bikerglen/rp2040-midi-player/case/dac-version/standoff M2 x 5 x 7.8 mm.3mf

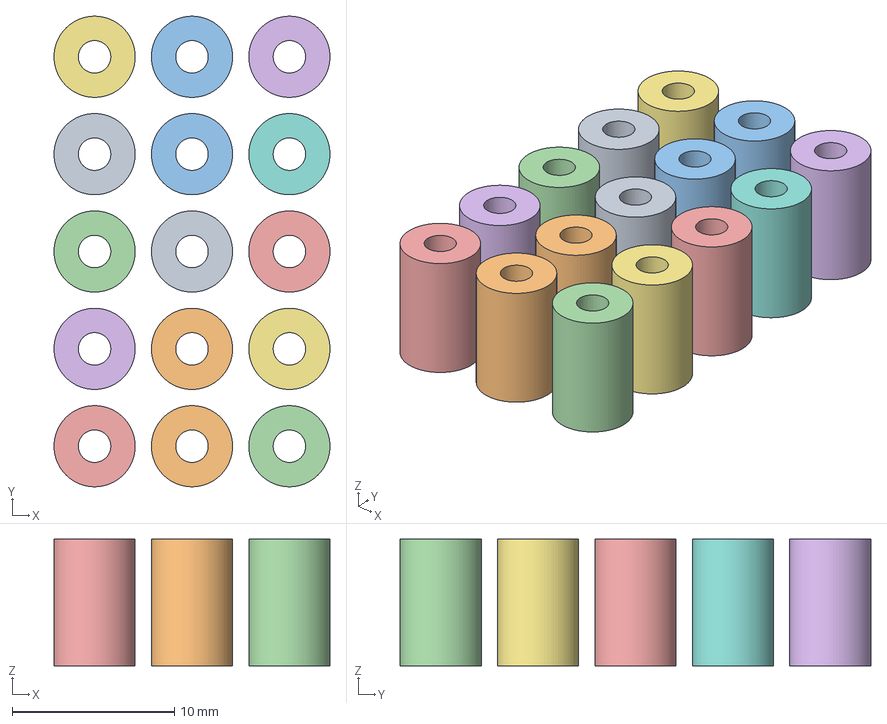
[picture p1: CAD file, 2026-02-13]
case/dac-version/standoff M2 x 5 x 7.8 mm.3mf
17.0 x 29.0 x 7.80 mm
