bikerglen/rp2040-midi-player/case/led-light-guide/lightguides 2.2mm.3mf

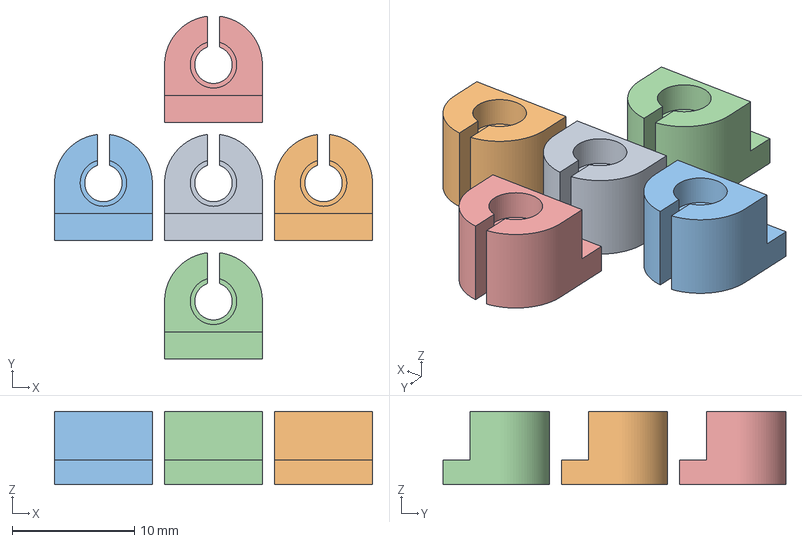
[picture p2: CAD file, 2026-02-07]
case/led-light-guide/lightguides 2.2mm.3mf
26.0 x 28.0 x 6.00 mm
