bikerglen/rp2040-midi-player/case/midi-fighter-stand/Midi Fighter Stand.3mf

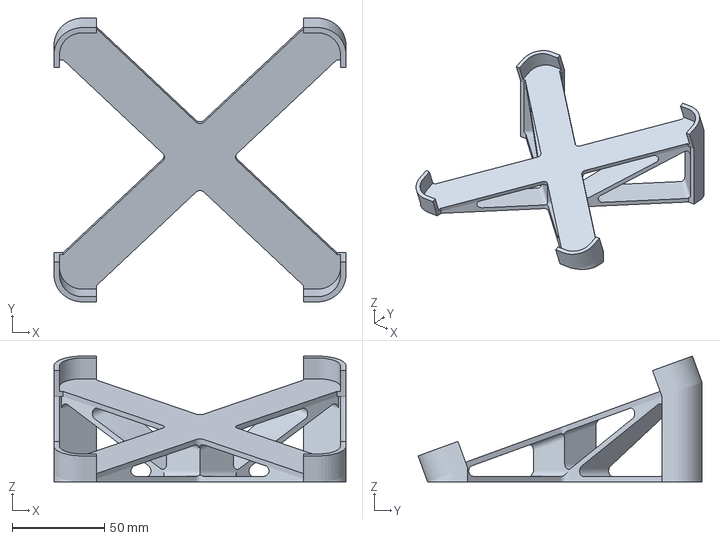
[picture p3: CAD file, 2026-02-12]
case/midi-fighter-stand/Midi Fighter Stand.3mf
158.0 x 153.6 x 68.1 mm
