bikerglen/rp2040-midi-player/case/noise-box-2000/noise-box-2000-led.3mf

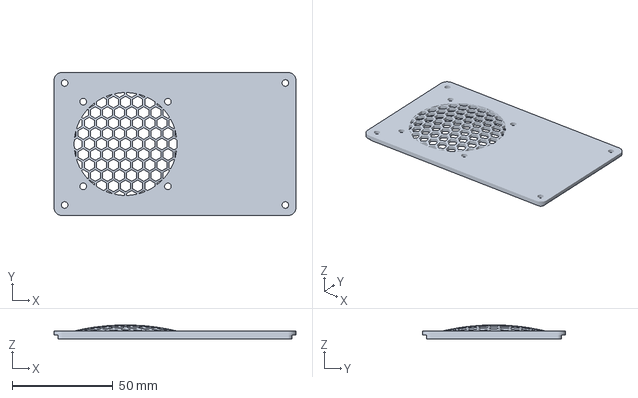
[picture p4: CAD file, 2026-02-18]
case/noise-box-2000/noise-box-2000-led.3mf
120.0 x 71.0 x 6.97 mm
