bikerglen/rp2040-midi-player/case/spkr-version/midi player speaker body, gray basic.3mf

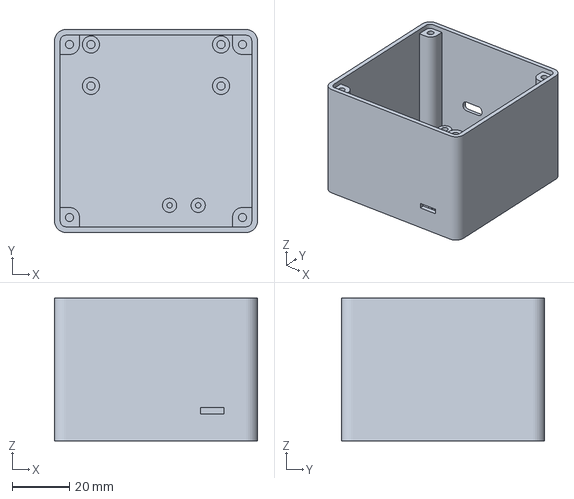
[picture p5: CAD file, 2026-02-07]
case/spkr-version/midi player speaker body, gray basic.3mf
71.0 x 71.0 x 50.0 mm
