bikerglen/rp2040-midi-player/case/dac-version/midi player dac box matte gray pla.3mf

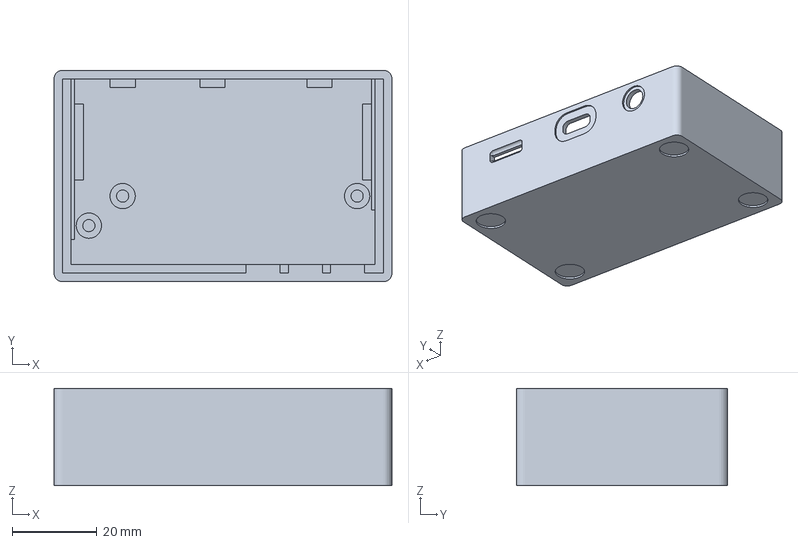
[picture p6: CAD file, 2026-02-13]
case/dac-version/midi player dac box matte gray pla.3mf
80.0 x 50.0 x 23.0 mm
