bikerglen/rp2040-midi-player/case/spkr-version/midi player speaker lid, yellow and red.3mf

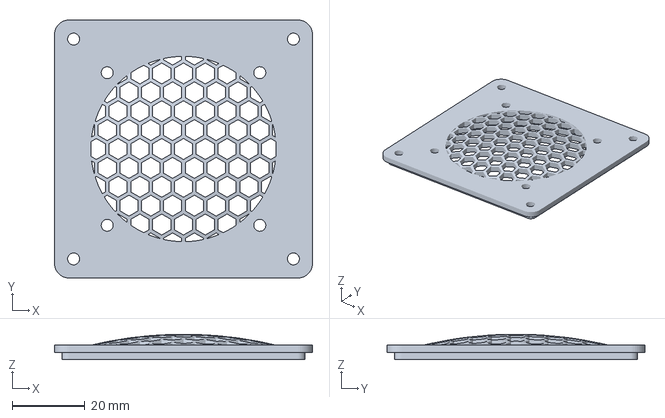
[picture p8: CAD file, 2026-02-07]
case/spkr-version/midi player speaker lid, yellow and red.3mf
71.0 x 71.0 x 6.97 mm
