bikerglen/rp2040-midi-player/case/dac-version/midi player dac lid matte gray pla.3mf

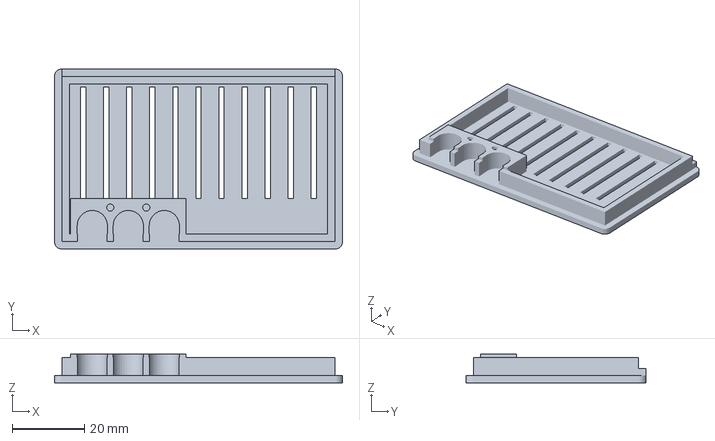
[picture p9: CAD file, 2026-02-07]
case/dac-version/midi player dac lid matte gray pla.3mf
80.0 x 50.0 x 8.00 mm
