bikerglen/rp2040-midi-player/case/spkr-version/led cover for base mount.3mf

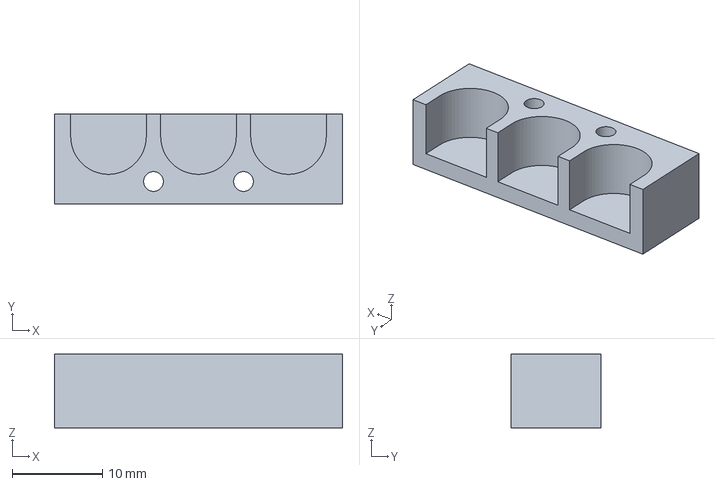
[picture p10: CAD file, 2026-02-07]
case/spkr-version/led cover for base mount.3mf
32.0 x 10.0 x 8.20 mm
