bikerglen/rp2040-midi-player/pcb/qwiic-led-board/leds-2.pdf

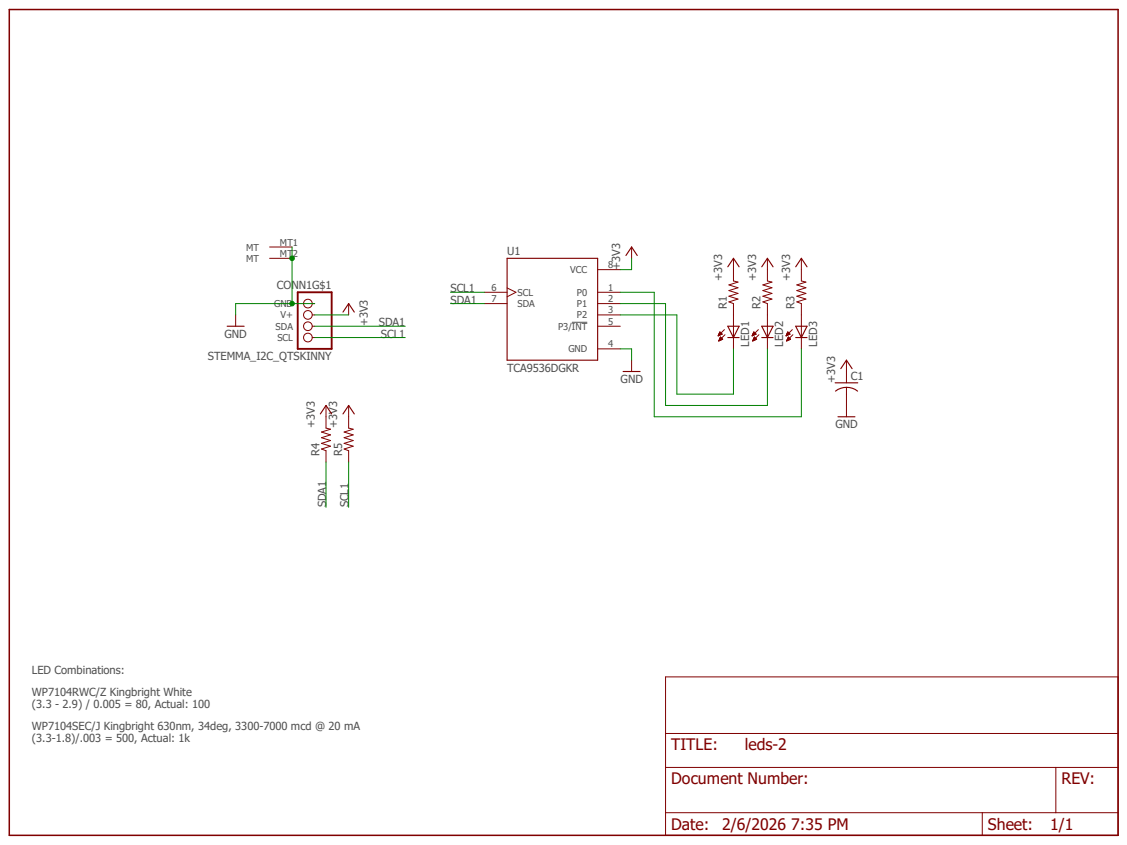
[picture p11: page 1]
TCA9536DGKR; STEMMA_I2C_QTSKINNY; GND; GND ⁺³V3 +³V3; LED¹; LED²; LED³; 4 P3/INT; SCL 6; SDA 7; VCC; GND V+ SDA SCL; CONN1G$1 MT; SDA1; SDA1 SDA¹; SCL1; SCL1 SCL1; TITLE:; leds-2

LED Combinations:
WP7104RWC/Z Kingbright White
(3.3 - 2.9) / 0.005 = 80, Actual: 100
WP7104SEC/J Kingbright 630nm, 34deg, 3300-7000 mcd @ 20 mA
(3.3-1.8)/.003 = 500, Actual: 1k

Document Number: | REV:

Date: 2/6/2026 7:35 PM | Sheet: 1/1
