bikerglen/rp2040-midi-player/pcb/dac-version/soundboard-qtpy-usd-dac-smaller-v02.pdf

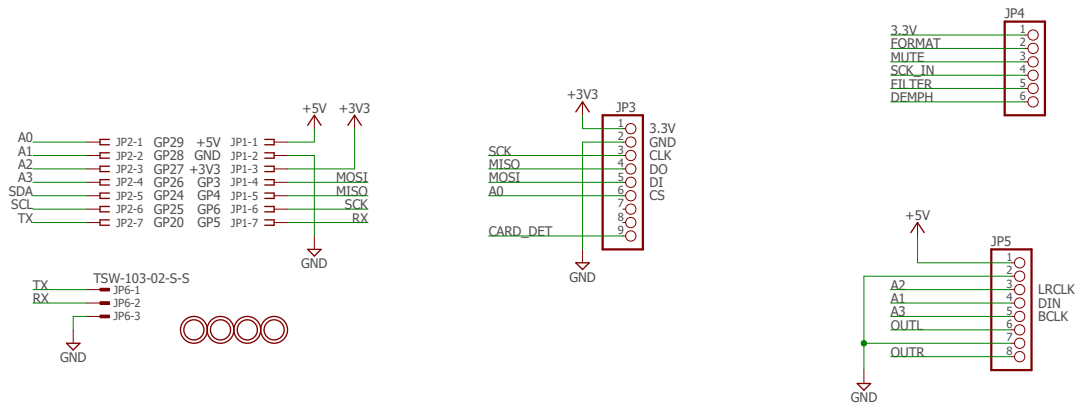
[picture p12: page 1]
GND; 3.3V GND CLK DO DI CS; LRCLK DIN BCLK; TSW-103-02-S-S; MOSI; MISO; SCK; SCL; SDA; CARD_DET; OUTL; OUTR; MUTE; SCK_IN; DEMPH; FORMAT; FILTER; TITLE:

soundboard-qtpy-usd-dac-smaller-v02

Document Number: | REV:

Date: 2/6/2026 7:32 PM | Sheet: 1/1
