bikerglen/rp2040-midi-player/pcb/spkr-version/soundboard-qtpy-bff-v01.pdf

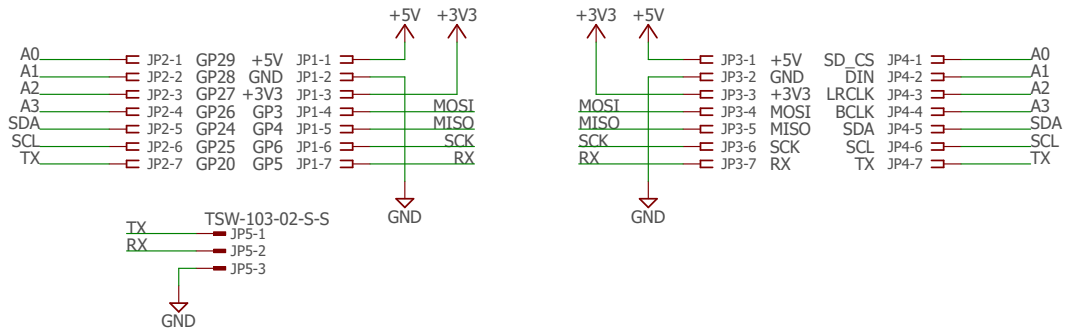
[picture p13: page 1]
GND; +5V SD_CS DIN +3V3 LRCLK MOSI MISO SCK RX; BCLK SDA SCL TX; TSW-103-02-S-S; JP4-7 MOSI; MOSI; MISO; SCK; SCL; SDA; TITLE:

soundboard-qtpy-bff-v01

Document Number: | REV:

Date: 2/6/2026 7:22 PM | Sheet: 1/1
