bikerglen/rp2040-midi-player/pcb/qwiic-led-board/leds-2.brd

## EAGLE design pcb/qwiic-led-board/leds-2.brd (2026-02-07)

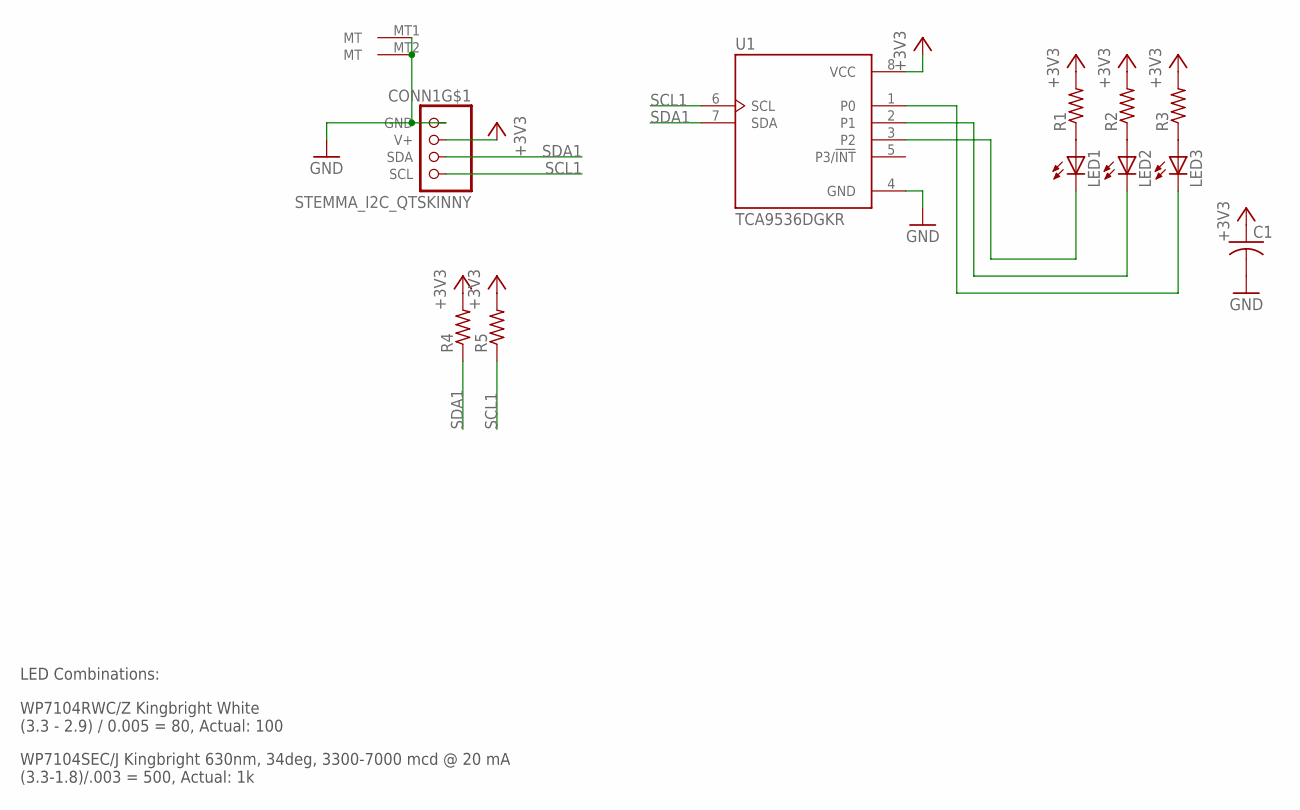
[picture p14: schematic leds-2.sch]

Parts:
C1: C-USC0603K; C0603K
CONN1: STEMMA_I2C_QTSKINNY; JST_SH4_SKINNY
LED1, LED2, LED3: LED3MM
R1, R2, R3, R4, R5: R-US_R0603; R0603
U1: TCA9536DGKR; SOP65P490X110-8N

Connections:
+3V3: C1.1, CONN1.2 (V+), R1.2, R2.2, R3.2, R4.2, R5.2, U1.8 (VCC)
GND: C1.2, CONN1.1 (GND), CONN1.MT1 (MT), CONN1.MT2 (MT), U1.4 (GND)
unnamed: LED3.K (C), U1.1 (P0)
unnamed: LED2.K (C), U1.2 (P1)
unnamed: LED1.K (C), U1.3 (P2)
unnamed: LED1.A, R1.1
unnamed: LED2.A, R2.1
unnamed: LED3.A, R3.1
SCL1: CONN1.4 (SCL), R5.1, U1.6 (SCL)
SDA1: CONN1.3 (SDA), R4.1, U1.7 (SDA)

Notes on the sheet:
LED Combinations:
WP7104RWC/Z Kingbright White (3.3 - 2.9) / 0.005 = 80, Actual: 100
WP7104SEC/J Kingbright 630nm, 34deg, 3300-7000 mcd @ 20 mA (3.3-1.8)/.003 = 500, Actual: 1k

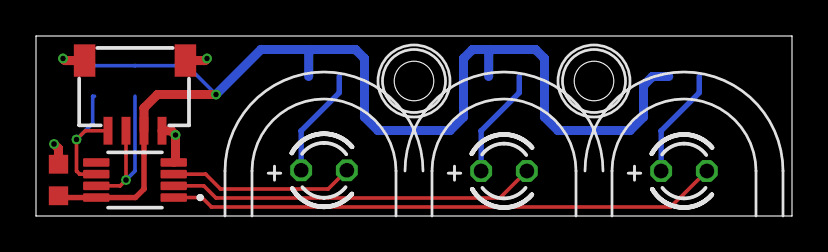
[picture p15: board leds-2.brd from above]

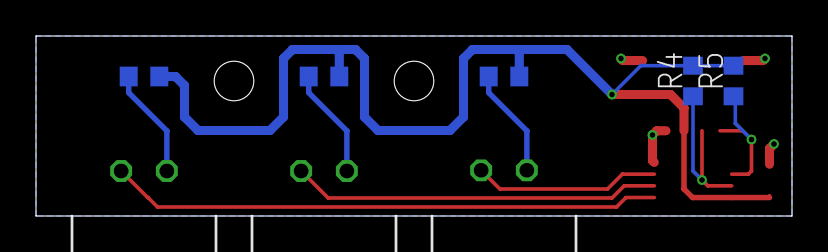
[picture p16: board leds-2.brd from below]

Board: 2 copper layers, 42.0 x 10.0 mm, 11 parts (5 on the bottom side), 10 nets.
