bikerglen/rp2040-midi-player/pcb/dac-version/soundboard-qtpy-usd-dac-smaller-v02.brd

## EAGLE design pcb/dac-version/soundboard-qtpy-usd-dac-smaller-v02.brd (2026-02-07)

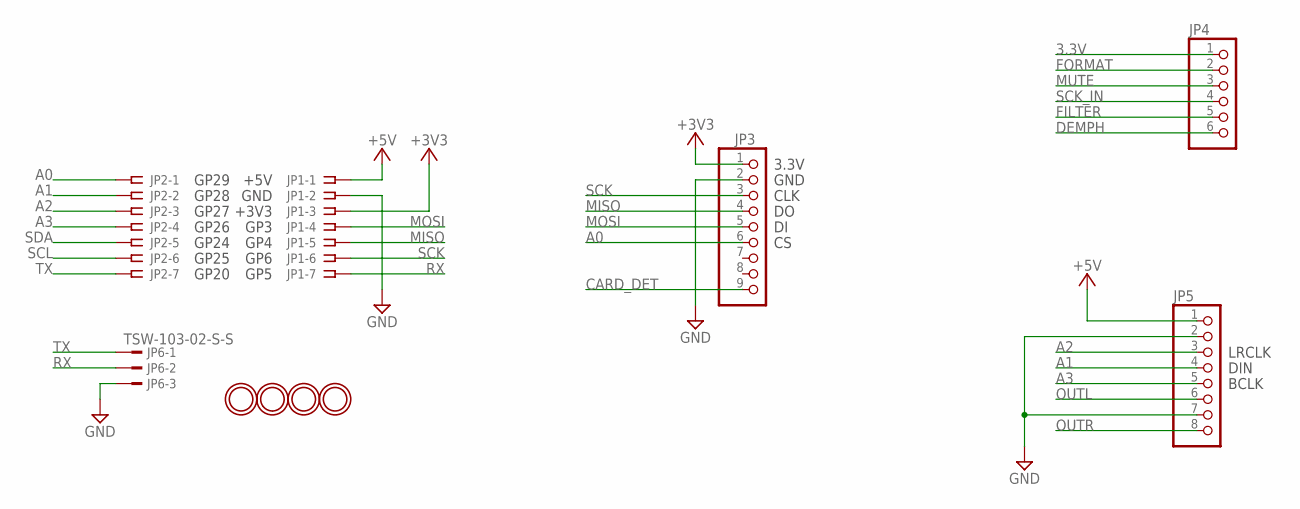
[picture p17: schematic soundboard-qtpy-usd-dac-smaller-v02.sch]

Parts:
JP1, JP2: SSW-107-02-S-S
JP3: HEADER-1X970MIL; 1X09_ROUND_70
JP4: HEADER-1X670MIL; 1X06_ROUND_70
JP5: HEADER-1X8ROUND; 1X08_ROUND
JP6: TSW-103-02-S-S
U$11, U$12, U$13, U$14: MOUNTINGHOLE2.5; MOUNTINGHOLE_2.5_PLATED

Connections:
3.3V: JP4.1
+3V3: JP1.3, JP3.1
+5V: JP1.1, JP5.1
A0: JP2.1, JP3.6
A1: JP2.2, JP5.4
A2: JP2.3, JP5.3
A3: JP2.4, JP5.5
CARD_DET: JP3.9
DEMPH: JP4.6
FILTER: JP4.5
FORMAT: JP4.2
GND: JP1.2, JP3.2, JP5.2, JP5.7, JP6.3
MISO: JP1.5, JP3.4
MOSI: JP1.4, JP3.5
MUTE: JP4.3
OUTL: JP5.6
OUTR: JP5.8
RX: JP1.7, JP6.2
SCK: JP1.6, JP3.3
SCK_IN: JP4.4
SCL: JP2.6
SDA: JP2.5
TX: JP2.7, JP6.1

Notes on the sheet:
GND
+5V
GP29
GP28
GP27
+3V3
GP3
GP4
GP6
GP5
GP26
GP24
GP25
GP20
3.3V
CLK
LRCLK
DIN
BCLK

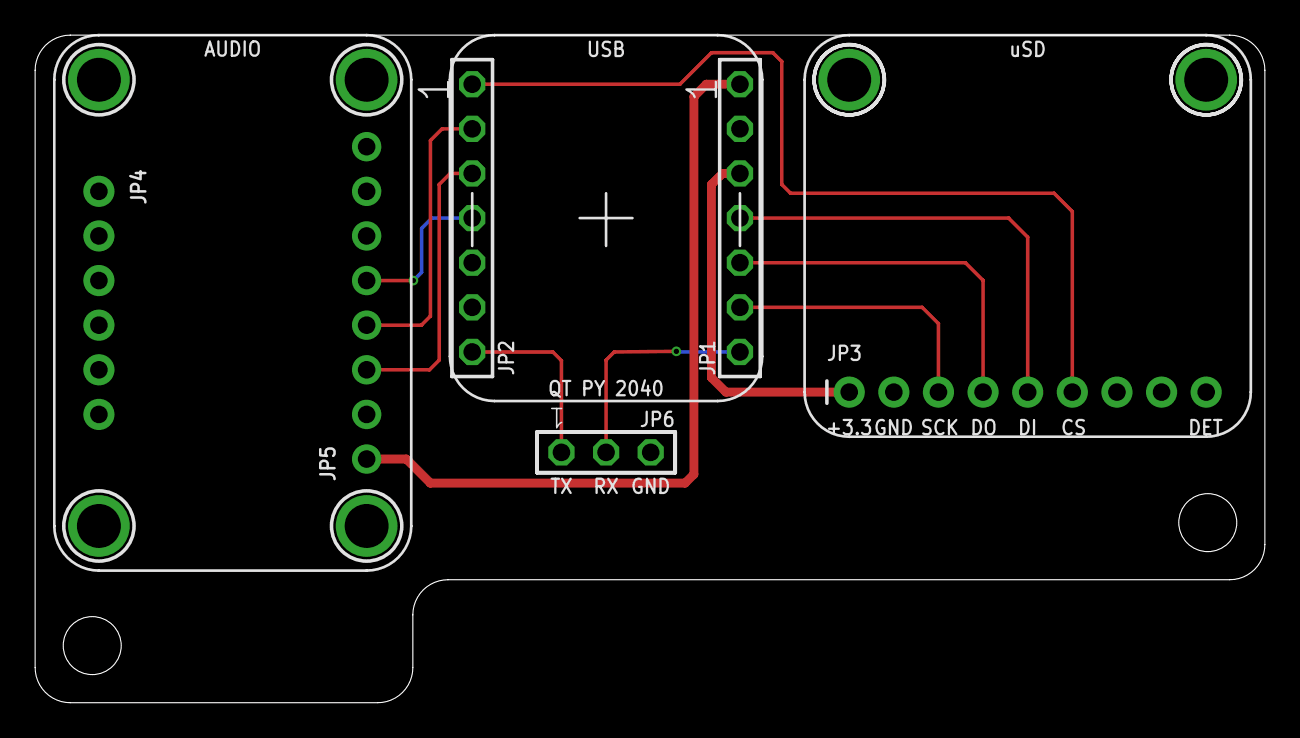
[picture p18: board soundboard-qtpy-usd-dac-smaller-v02.brd from above]

Board: 2 copper layers, 70.0 x 38.0 mm, 26 parts (0 on the bottom side), 12 nets.

Other parts of the board:
PLABEL0: PLABEL0
PLABEL1: PLABEL1
PLABEL2: PLABEL2
PLABEL3: PLABEL3
PLABEL4: PLABEL4
PLABEL5: PLABEL5
PLABEL6: PLABEL6
PLABEL7: PLABEL7
PLABEL8: PLABEL8
PLABEL9: PLABEL9
PLABEL10: PLABEL10
PLABEL11: PLABEL11
PLABEL12: PLABEL12
PLABEL13: PLABEL13
U$1, U$2: MOUNTINGHOLE2.5; MOUNTINGHOLE_2.5_PLATED
