bikerglen/rp2040-midi-player/pcb/spkr-version/soundboard-qtpy-bff-v01.brd

## EAGLE design pcb/spkr-version/soundboard-qtpy-bff-v01.brd (2026-02-07)

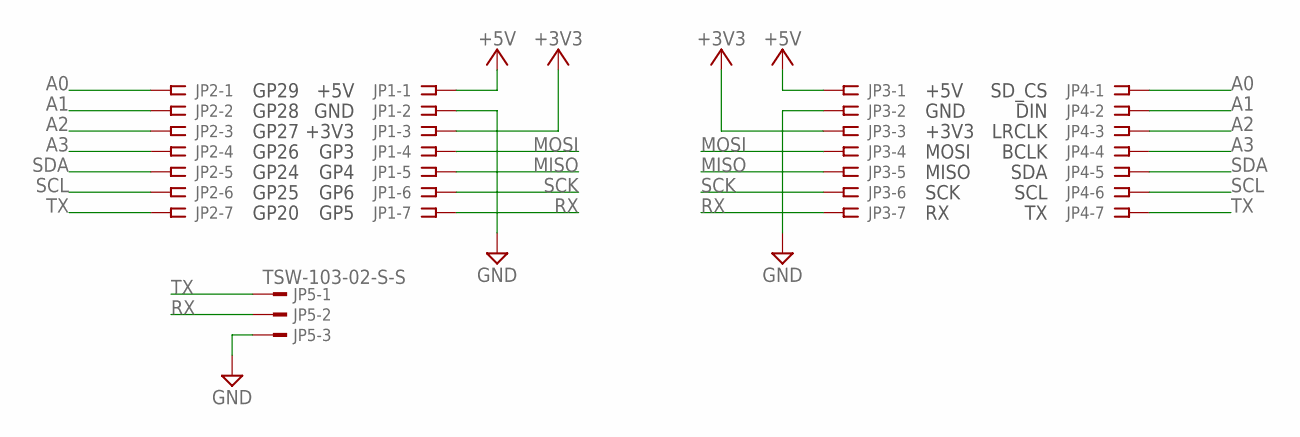
[picture p19: schematic soundboard-qtpy-bff-v01.sch]

Parts:
JP1, JP2, JP3, JP4: SSW-107-02-S-S
JP5: TSW-103-02-S-S

Connections:
+3V3: JP1.3, JP3.3
+5V: JP1.1, JP3.1
A0: JP2.1, JP4.1
A1: JP2.2, JP4.2
A2: JP2.3, JP4.3
A3: JP2.4, JP4.4
GND: JP1.2, JP3.2, JP5.3
MISO: JP1.5, JP3.5
MOSI: JP1.4, JP3.4
RX: JP1.7, JP3.7, JP5.2
SCK: JP1.6, JP3.6
SCL: JP2.6, JP4.6
SDA: JP2.5, JP4.5
TX: JP2.7, JP4.7, JP5.1

Notes on the sheet:
GND
+5V
GP29
GP28
GP27
+3V3
GP3
GP4
GP6
GP5
GP26
GP24
GP25
GP20
SD_CS
DIN
LRCLK
MOSI
MISO
SCK
BCLK
SDA
SCL

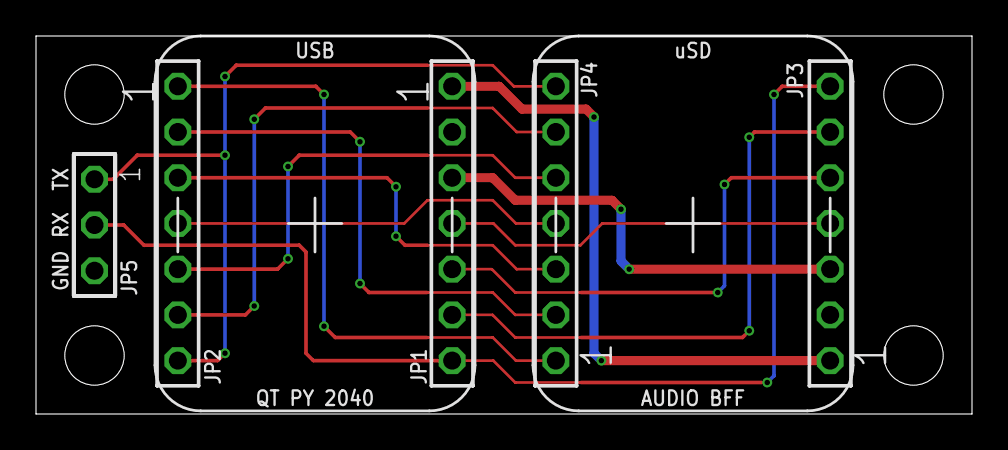
[picture p20: board soundboard-qtpy-bff-v01.brd from above]

Board: 2 copper layers, 52.0 x 21.0 mm, 5 parts (0 on the bottom side), 14 nets.
