bikerglen/rp2040-midi-player/(commit log)

2026-02-06 fix tabs and spacing
    [main.c]
2026-02-06 add tca9536-based i2c led status indicator code
2026-02-07 add speaker version design files, pdf, gerbers
    [soundboard-qtpy-bff-v01.brd, soundboard-qtpy-bff-v01.sch]
2026-02-07 add pcb design files, pdf schematic, and gerbers
    [soundboard-qtpy-usd-dac-smaller-v02.brd, soundboard-qtpy-usd-dac-smaller-v02.sch]
2026-02-07 add led board design files, schematic, and gerbers
    [leds-2.brd, leds-2.sch]
2026-02-07 add enclosures for both speaker and dac versions
    [led cover for base mount.3mf, lightguides 2.2mm.3mf, midi player dac box matte gray pla.3mf, midi player dac lid matte gray pla.3mf, midi player speaker body, gray basic.3mf, midi player speaker lid, yellow and red.3mf]
2026-02-12 add i2c expander example
2026-02-12 add stand for midi fighter twister or midi fighter spectra
    [Midi Fighter Stand.3mf]
2026-02-13 increase board to board spacing from 7.5 to 8.0 mm
    [midi player dac box matte gray pla.3mf]
2026-02-13 add standoffs
    [standoff M2 x 5 x 8 mm.3mf]
2026-02-13 add 7.8 mm standoff plate
    [standoff M2 x 5 x 7.8 mm.3mf]
2026-02-13 remove 8 mm standoff
    [standoff M2 x 5 x 8 mm.3mf]
2026-02-18 add noise box 2000 enclosure for speaker version
    [noise-box-2000-body.3mf, noise-box-2000-led.3mf]
